celikonline/ormanyangindedektor/hardware/mechanical/ON1_mechanical.pdf

1

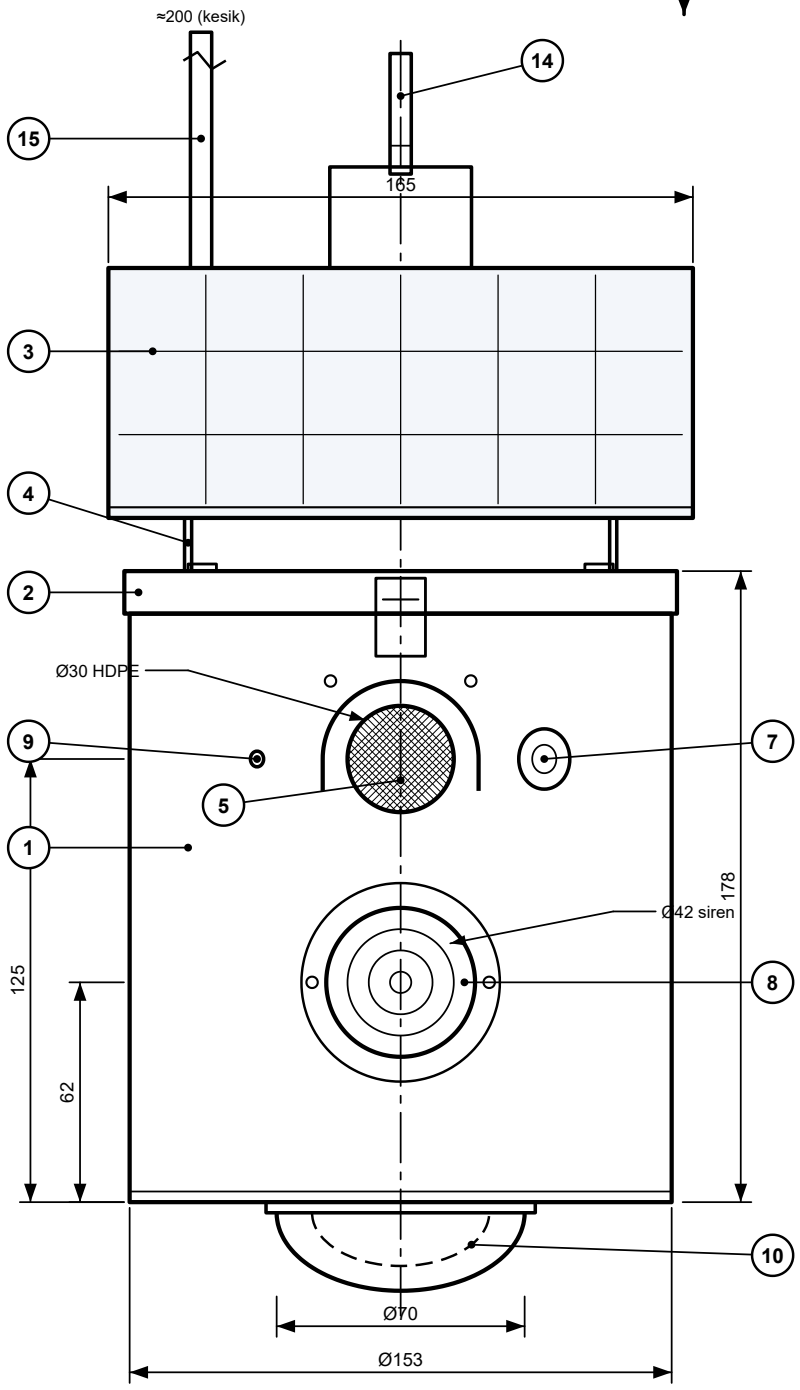
[picture p2: figure]
≈200 (kesik); Ø30 HDPE; Ø42 siren

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
A | A
B | B
C | C
D | D
E | E
F | F

## ORMAN NÖBETÇİSİ

Model ON-1

Proje / Çizim başlığı

## Orman Nöbetçisi ON-1 — Gövde montajı

Mekanik resim 1/2: ön, yan ve üst görünüşler

Doküman no
ON1-MEC-001

Revizyon
A

Tarih
2026-11-10

Sayfa
1/2

Boyut
A3 yatay

Ölçek
1:2

Çizen
Algosense Danışmanlık

Onay
—

Tek doğru kaynak: SPEC.md Rev A • Bu çizim programla üretilmiştir (hardware/tools) — elle düzenlemeyin.

# ÖN GÖRÜNÜŞ

## Ölçek 1:2

35°

FOV 60°

halat → dal

ağaç kabuğu

15

30°

### ≈ 195 (siperlik – braket)

### 117 (135 × cos30°)

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
10 11

# A — SAĞ YAN GÖRÜNÜŞ

## Ölçek 1:2 (ön solda, ağaç sağda)

görüş ±30°

ağaç (örnek Ø300; Ø150…600)

38° | 38°

32°

165

117

2

4

15 16

7

6

# B — ÜST GÖRÜNÜŞ

## Ölçek 1:2 (ön aşağıda)

A

B

## PARÇA / ÖZELLİK LİSTESİ

1

Gövde: kalaylı sac teneke Ø153 × 178, dış RAL 9010 ısı yansıtıcı epoksi, iç astar + 5 mm Al-yüzlü PE köpük

### 2 Kapak + EPDM conta + 3 paslanmaz kilit klipsi (0° / 120° / 240°)

### 3 Güneş paneli 6 V 3 W ETFE 165 × 135, 30° eğim — güneşlik görevi

4

Al 5052 panel braketi (2 yan yanak, 4×M4 kapağa), panel–kapak 15 mm hava boşluğu

### 5 Termal pencere Ø30: HDPE 0,4 mm + paslanmaz tel örgü (cam/akrilik yok)

### 6 Yağmur siperliği; AMG8833 ekseni yataydan 35° aşağı, FOV 60°

### 7 M12 ePTFE membran vent (BME680 haznesi), θ = +32°

### 8 Piezo siren Ø42, 12 V 105 dB, 2×M3 flanş

### 9 Durum LED’i ışık borusu Ø3, θ = −32°

### 10 Alt PC kubbe Ø70 (6 × 1 W LED halkası Ø50) + mıknatıs test noktası (SW3)

### 11 M8 ePTFE basınç dengeleme + labirentli drenaj (alt kapak)

### 12 Paslanmaz L braket 2 mm, 2×M5 + 10 mm aralayıcı, iç takviye pulu

### 13 Paslanmaz bant kelepçe (Ø15–60 cm ağaç), braket yarıklarından geçer

### 14 M6 mapa + 2 mm paslanmaz emniyet halatı (üst dala)

### 15 SMA dişi bulkhead (θ = 218°) + 90° adaptör + 3 dBi IP67 LTE anten (yukarı)

### 16 PG7 kablo rakoru (θ = 142°) — panel kablosu

## NOTLAR

1. Ölçüler mm. Genel tolerans ISO 2768-m. Delikler boyamadan önce açılır, çapakları alınır.
2. Tüm dış delikler EPDM/O-ring ile sızdırmaz; hedef IP54. Teneke iç yüzeyi astarlanır.
3. Anten zorunludur (teneke gövde Faraday kafesidir). Anten dikey yukarı.
4. Panel tabanı ile kapak arası ≥ 15 mm hava boşluğu: gövdeyi güneşten korur.
5. Delik konumları için sayfa 2 (delme şablonu) ve 1:1 şablon dosyalarına bakın.
6. Montaj yüksekliği 3–5 m; sensör yamaca / izlenecek alana bakacak şekilde döndürülür.

Görünüşler ok yöntemiyle (ISO 128-30) gösterilmiştir.

1

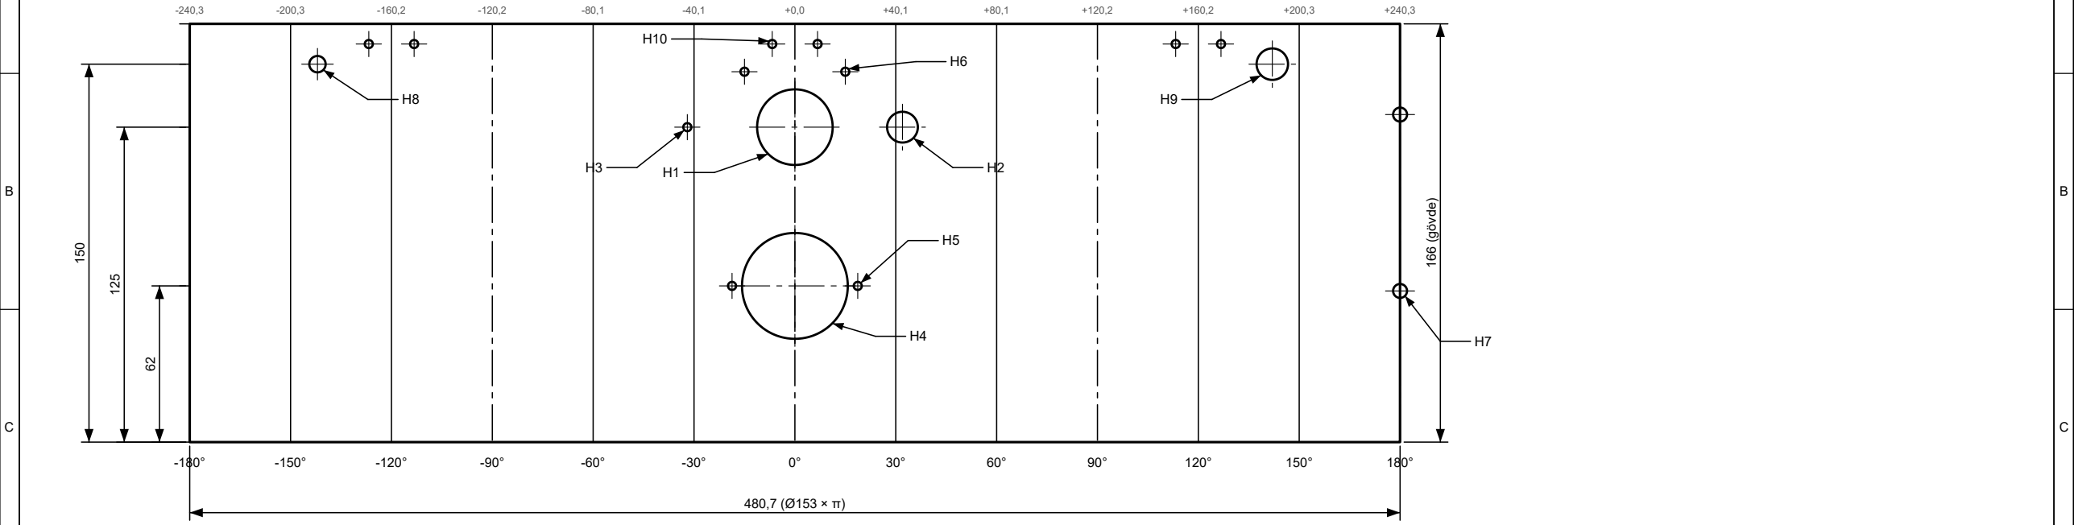
[picture p3: figure]
166 (gövde)

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
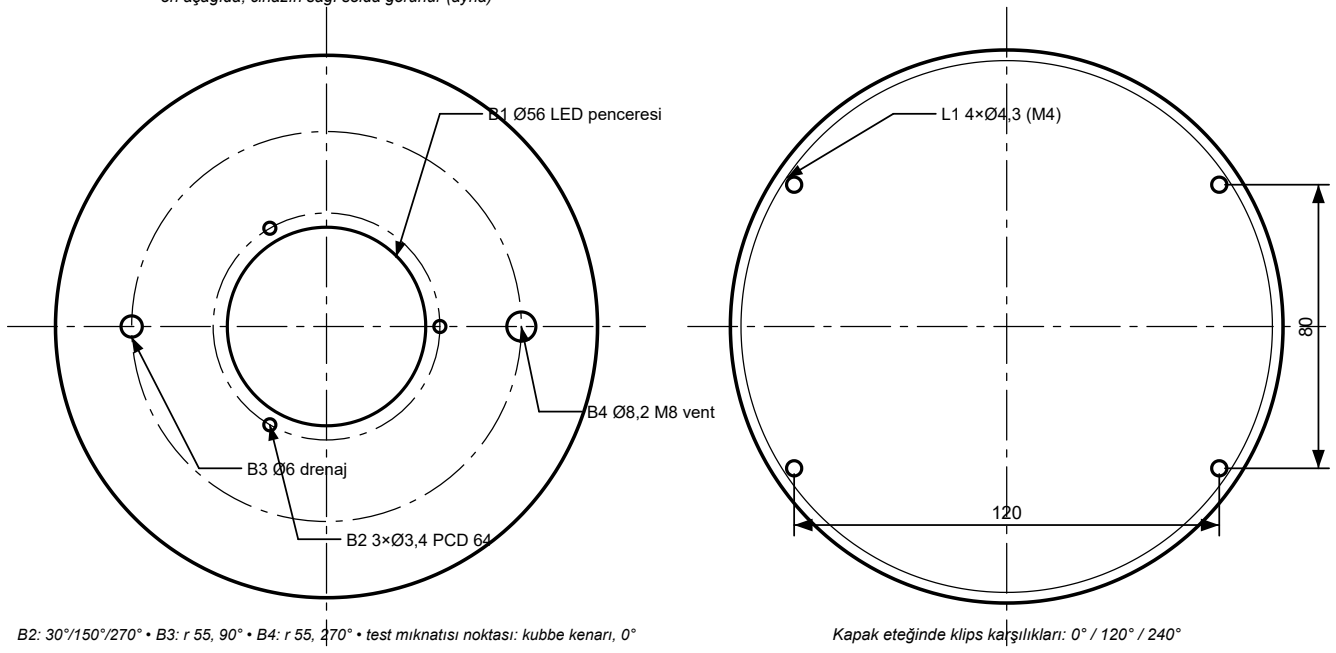
[picture p4: figure]
B1 Ø56 LED penceresi; B2 3×Ø3,4 PCD 64; B3 Ø6 drenaj; B4 Ø8,2 M8 vent

5

6

6

7

7

8

8

A | A
D | D
E | E
F | F

## ORMAN NÖBETÇİSİ

Model ON-1

Proje / Çizim başlığı

## Orman Nöbetçisi ON-1 — Delme şablonu

Mekanik resim 2/2: gövde, alt kapak, üst kapak

Doküman no
ON1-MEC-002

Revizyon
A

Tarih
2026-11-10

Sayfa
2/2

Boyut
A3 yatay

Ölçek
1:2

Çizen
Algosense Danışmanlık

Onay
—

Tek doğru kaynak: SPEC.md Rev A • Bu çizim programla üretilmiştir (hardware/tools) — elle düzenlemeyin.

ARKA | SOL | ÖN | SAĞ | ARKA

# GÖVDE YAN YÜZEY AÇINIMI (delme şablonu)

Ölçek 1:2 • yatay = yay uzunluğu s = R·θ (R = 76,5, çevre 480,7 mm) • dikey = tabandan yükseklik z

s (mm) →

## DELİK TABLOSU — yan yüzey (θ: önden saat yönünde, üstten bakış)

No | Özellik | θ (°) | s (mm) | z (mm) | Ø (mm) | Not
H1 | Termal pencere | 0 | +0,0 | 125 | 30 | HDPE 0,4 mm + tel örgü
H2 | M12 ePTFE vent | 32 | +42,7 | 125 | 12,2 | BME680 haznesi
H3 | Işık borusu | −32 | −42,7 | 125 | 3,2 | durum LED’i
H4 | Siren | 0 | +0,0 | 62 | 42 | flanş contalı
H5 | Siren flanş M3 | −18,7 / 18,7 | −25,0 / +25,0 | 62 | 3,2 | 2 adet, ±25 mm yay
H6 | Siperlik M3 | −15 / 15 | −20,0 / +20,0 | 147 | 3,2 | 2 adet, ±20 mm yay
H7 | L braket M5 | 180 | +240,3 | 60 / 130 | 5,5 | 2 adet, iç takviye pulu
H8 | SMA bulkhead | −142 | −189,6 | 150 | 6,5 | D-düz 6,0 mm, O-ring
H9 | PG7 rakor | 142 | +189,6 | 150 | 12,5 | panel kablosu
H10 | Klips perçini | 0 / 120 / −120, her biri ±6,74 | ±9,0 yay (merkez: 0 / ±160,2) | 158 | 3,2 | 6 adet (3 klips × 2)

## ALT KAPAK (taban) — dıştan (alttan) bakış

ön aşağıda; cihazın sağı solda görünür (ayna)

B2: 30°/150°/270° • B3: r 55, 90° • B4: r 55, 270° • test mıknatısı noktası: kubbe kenarı, 0°

## ÜST KAPAK — üstten bakış, ön aşağıda

Kapak eteğinde klips karşılıkları: 0° / 120° / 240°

1:1 şablonlar: ON1_drilling_template_wall_1to1.svg (520 × 230 mm) ve ON1_drilling_template_discs_1to1.svg (A3) — %100 ölçekle yazdırın, 100 mm kontrol çubuğunu ölçün.
