celikonline/ormanyangindedektor/hardware/mechanical/ON1_drilling_template.png

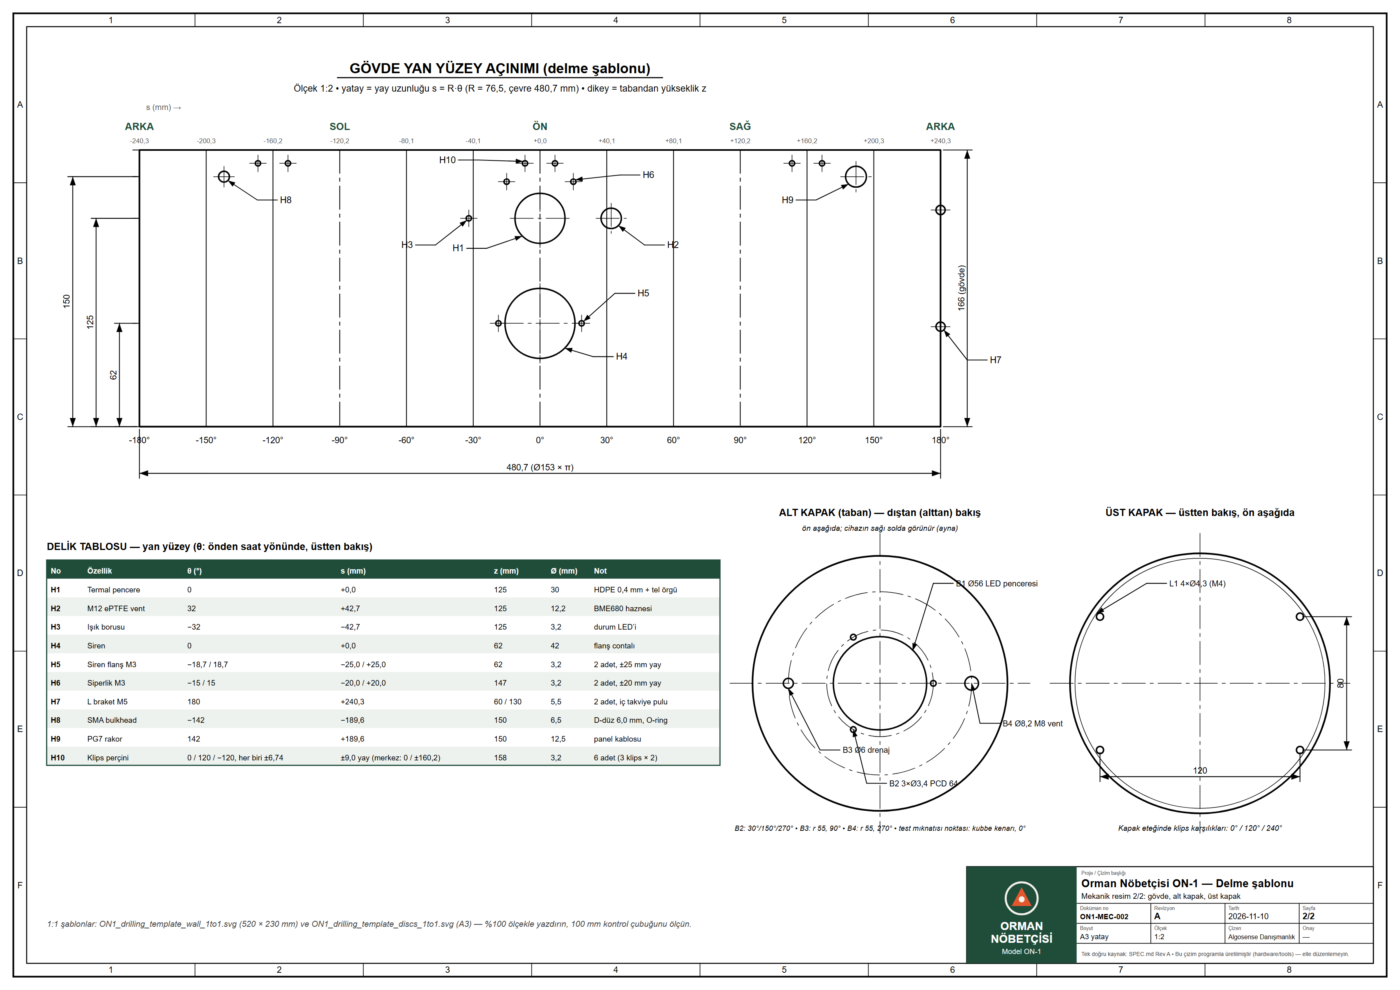
hardware/mechanical/ON1_drilling_template.png
