celikonline/ormanyangindedektor/hardware/pcb_diy/png/ON1-DIY_bakir_600dpi.png

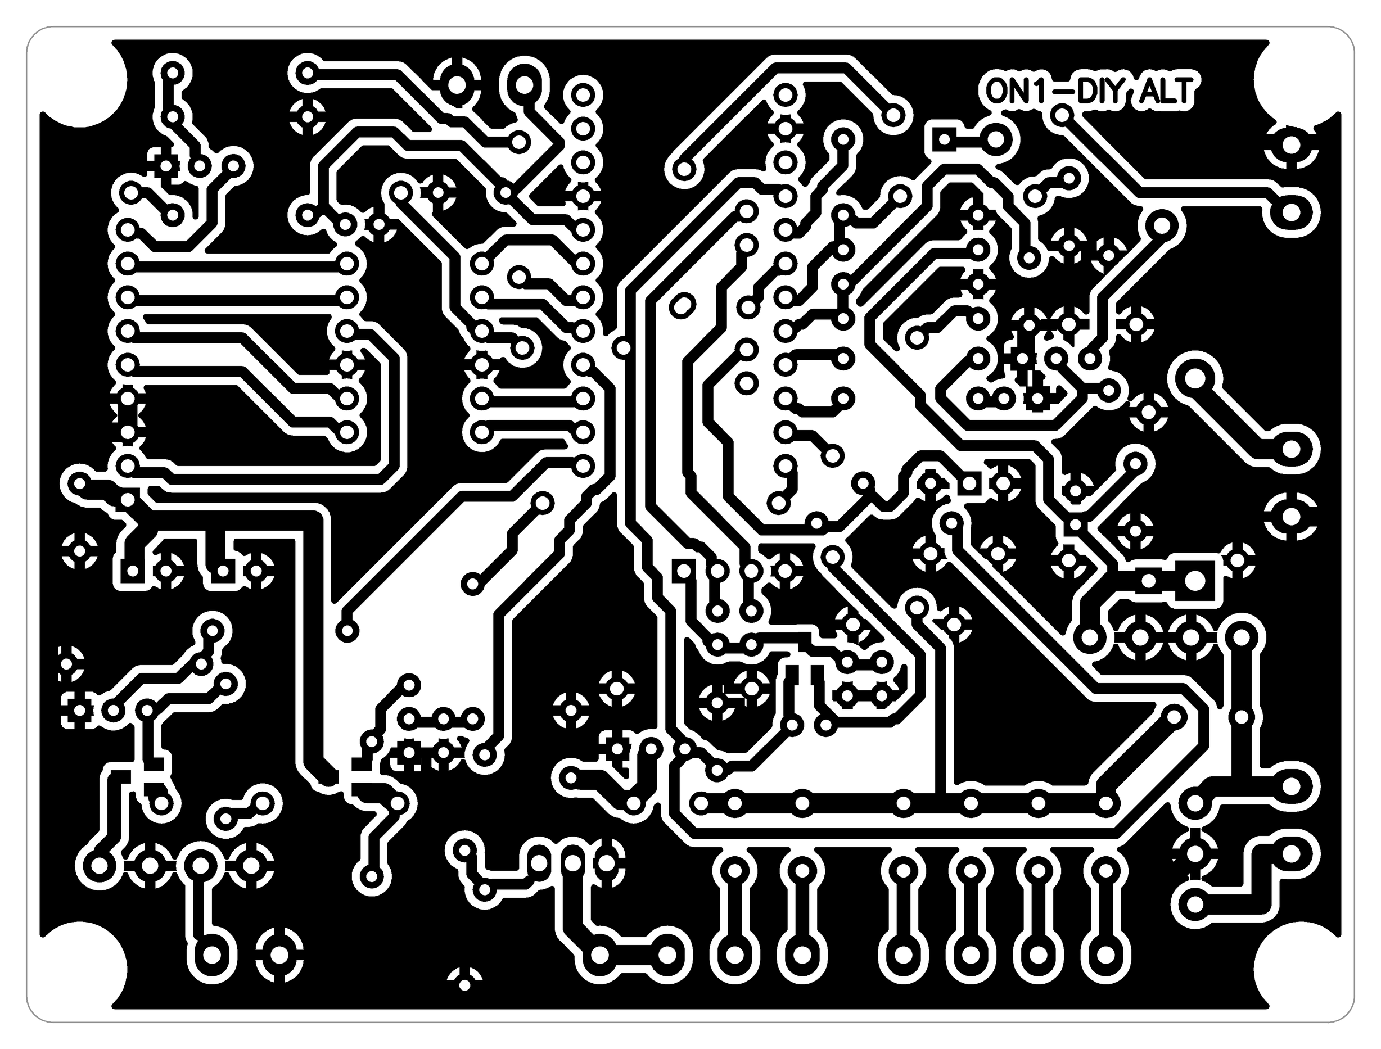
hardware/pcb_diy/png/ON1-DIY_bakir_600dpi.png
