celikonline/ormanyangindedektor/hardware/pcb_diy/png/ON1-DIY_onizleme_kompozit_600dpi.png

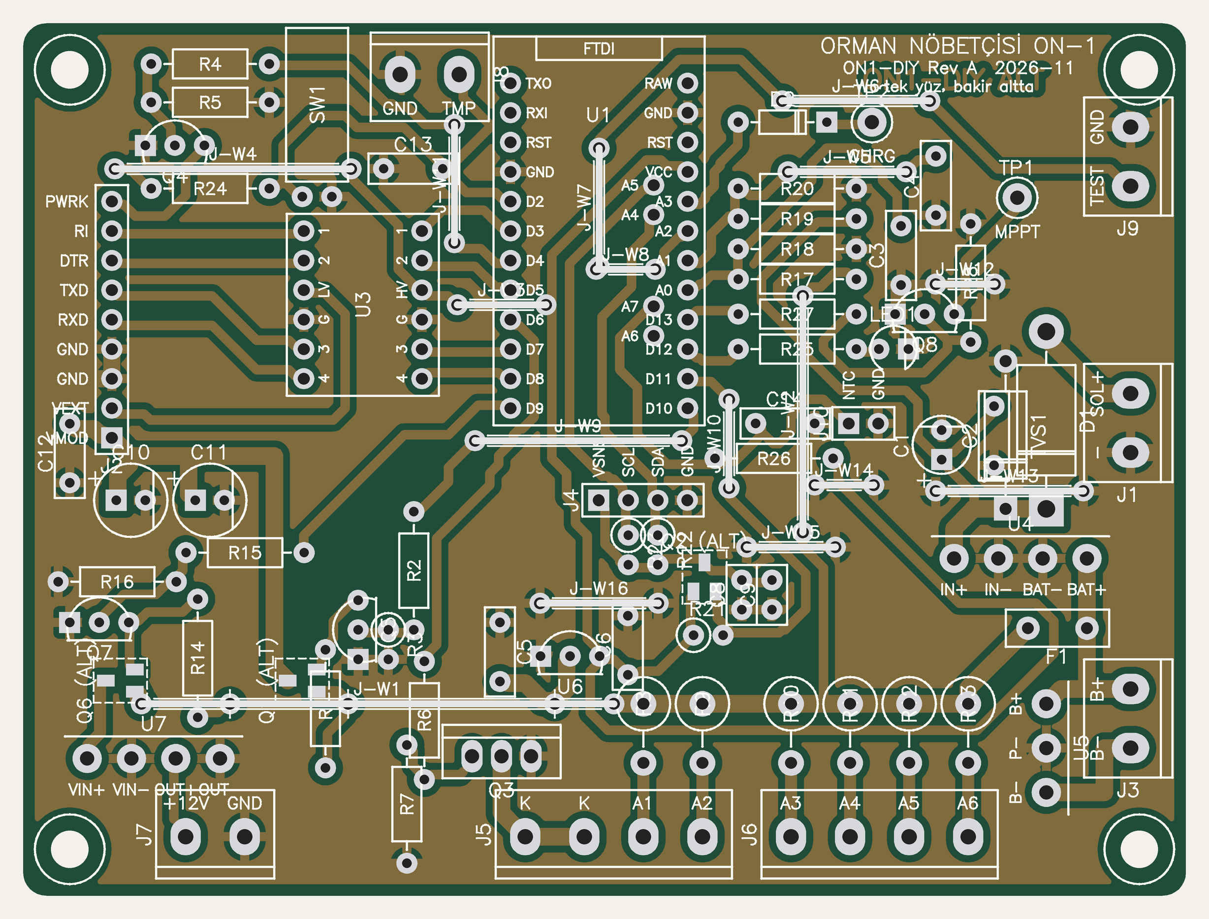
hardware/pcb_diy/png/ON1-DIY_onizleme_kompozit_600dpi.png
