celikonline/ormanyangindedektor/hardware/pcb_diy/png/ON1-DIY_onizleme_ust_600dpi.png

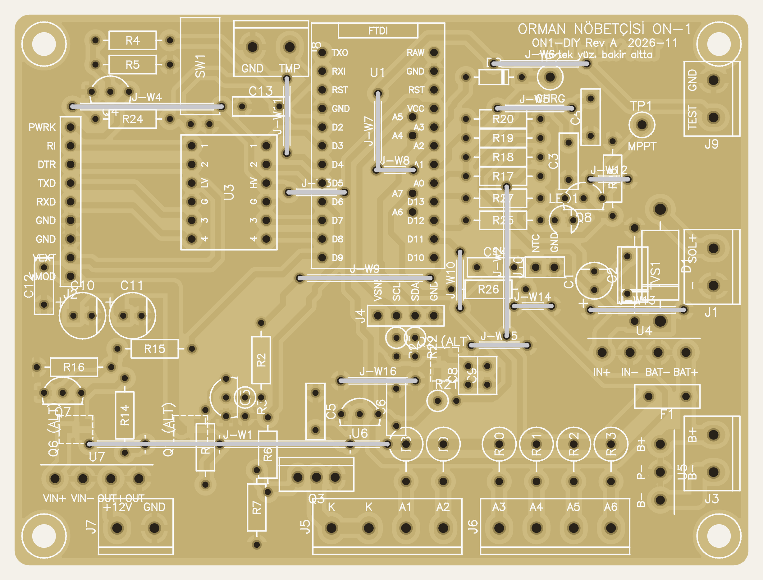
hardware/pcb_diy/png/ON1-DIY_onizleme_ust_600dpi.png
