celikonline/ormanyangindedektor/hardware/pcb_diy/png/ON1-DIY_serigrafi_600dpi.png

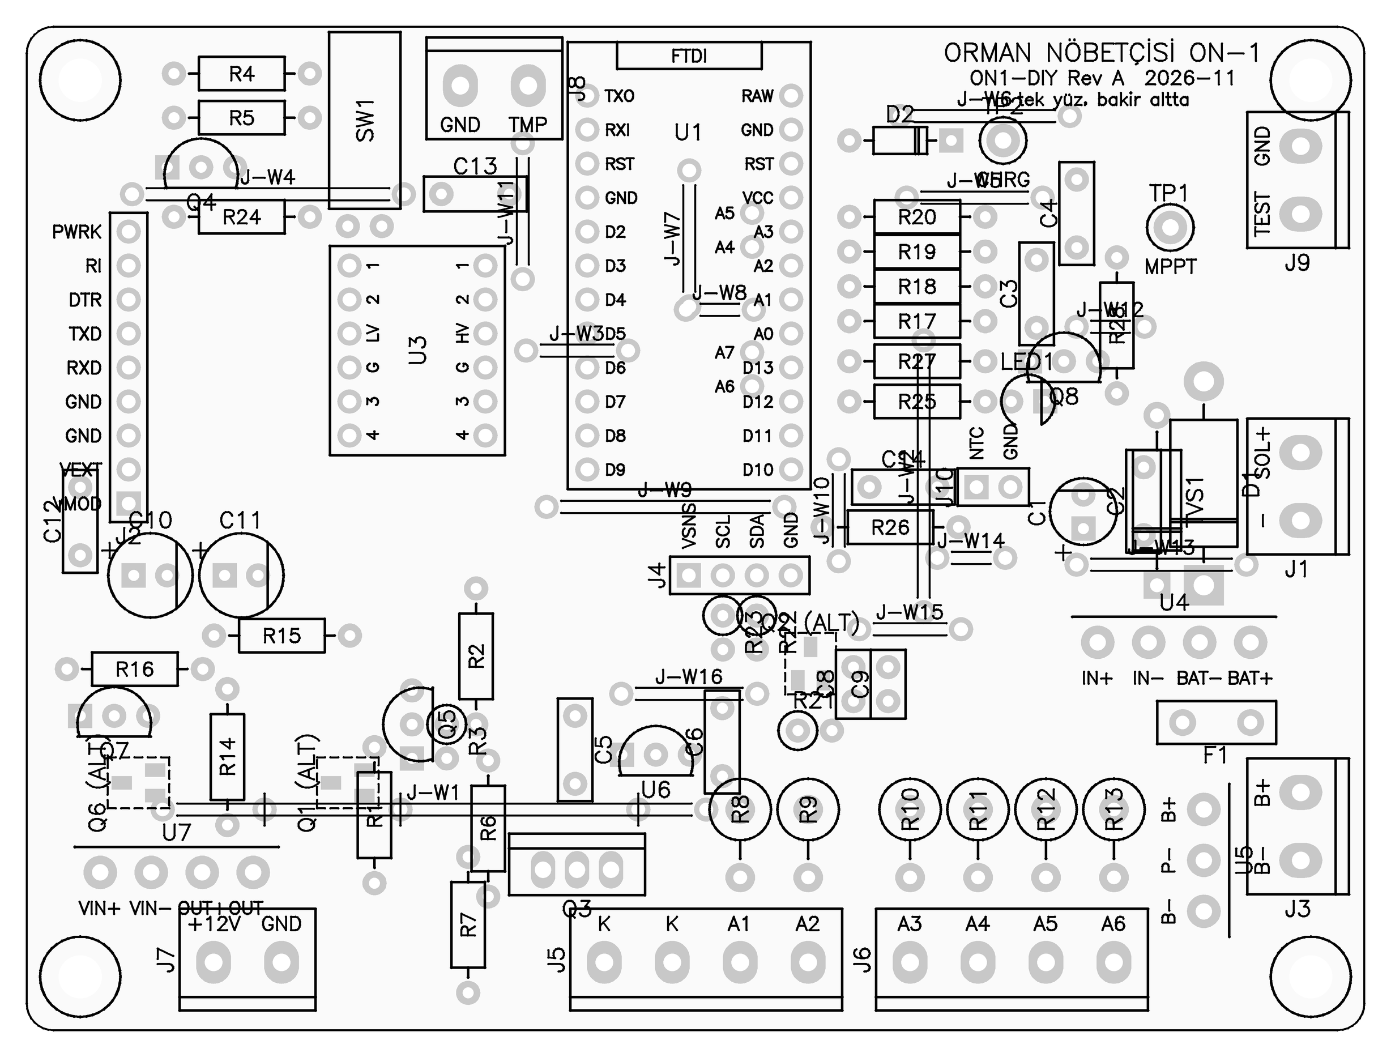
hardware/pcb_diy/png/ON1-DIY_serigrafi_600dpi.png
