celikonline/ormanyangindedektor/hardware/schematic/ON1-MB_RevA_schematic_sheet1.png

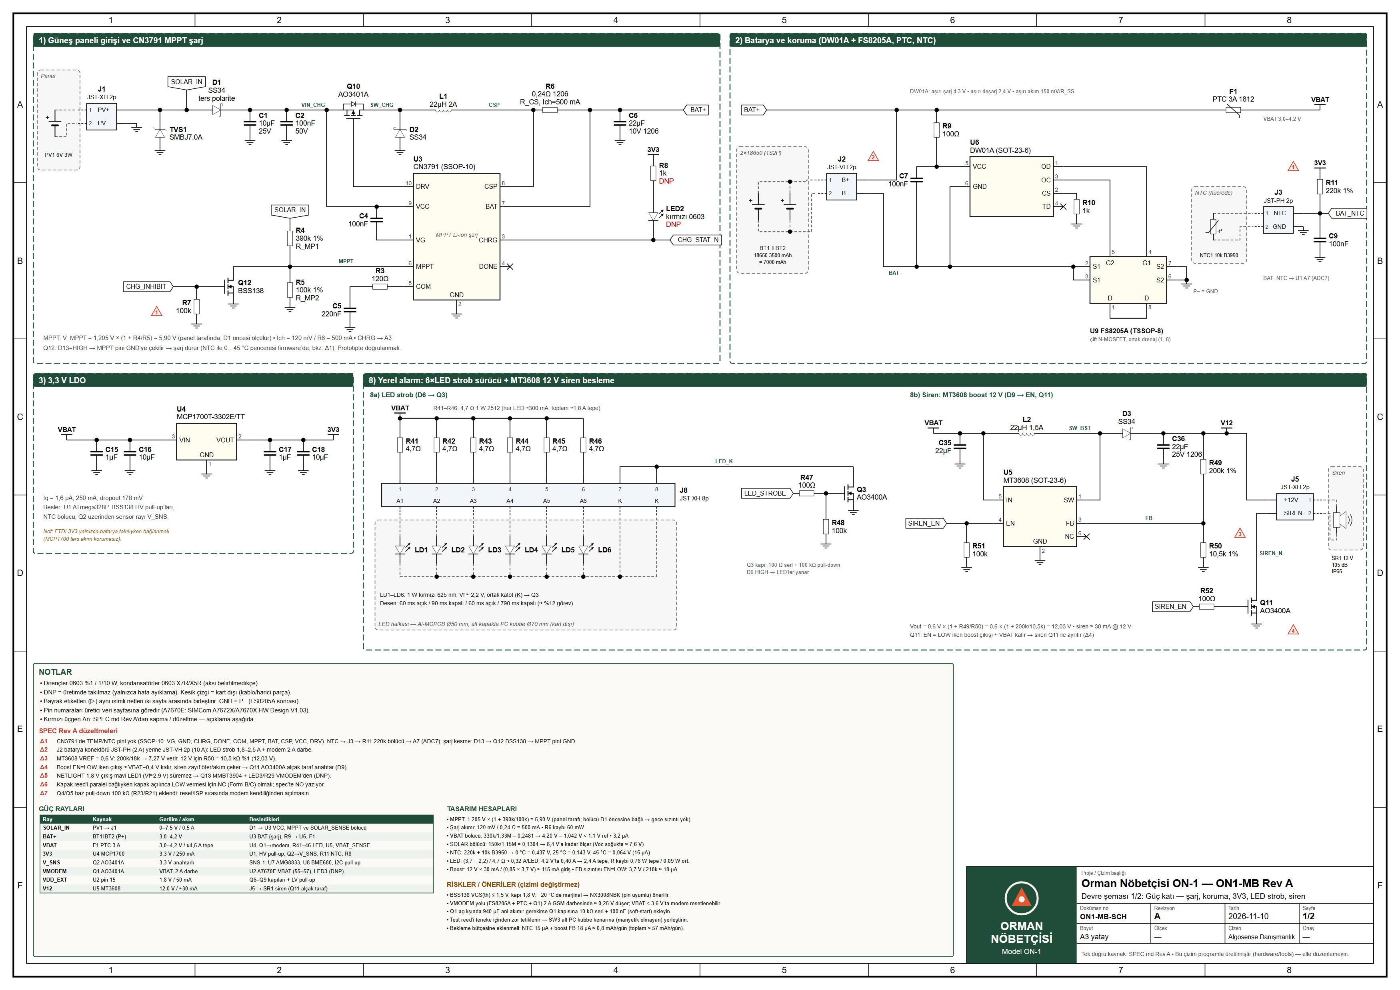
hardware/schematic/ON1-MB_RevA_schematic_sheet1.png
