celikonline/ormanyangindedektor/renders/on1_alarm.png

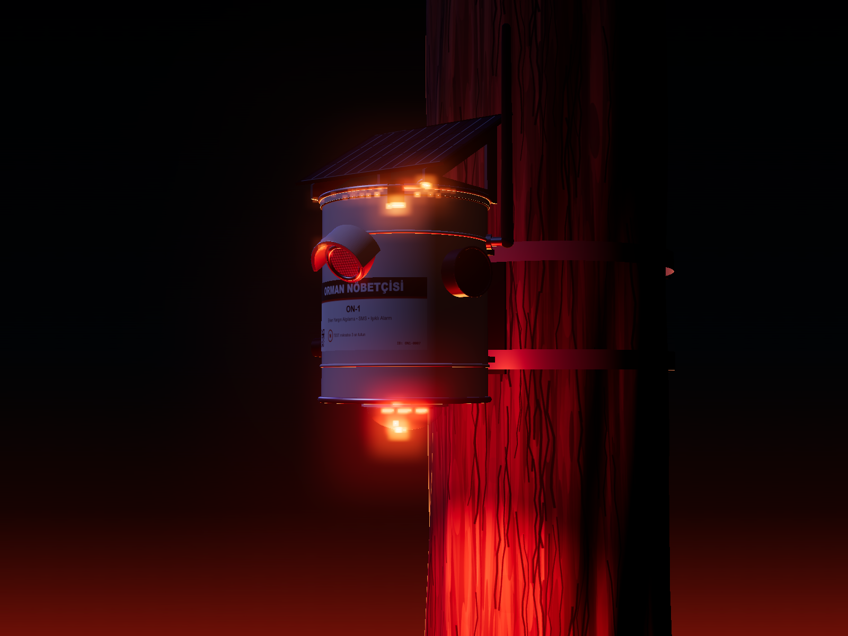
renders/on1_alarm.png
