celikonline/ormanyangindedektor/renders/on1_front.png

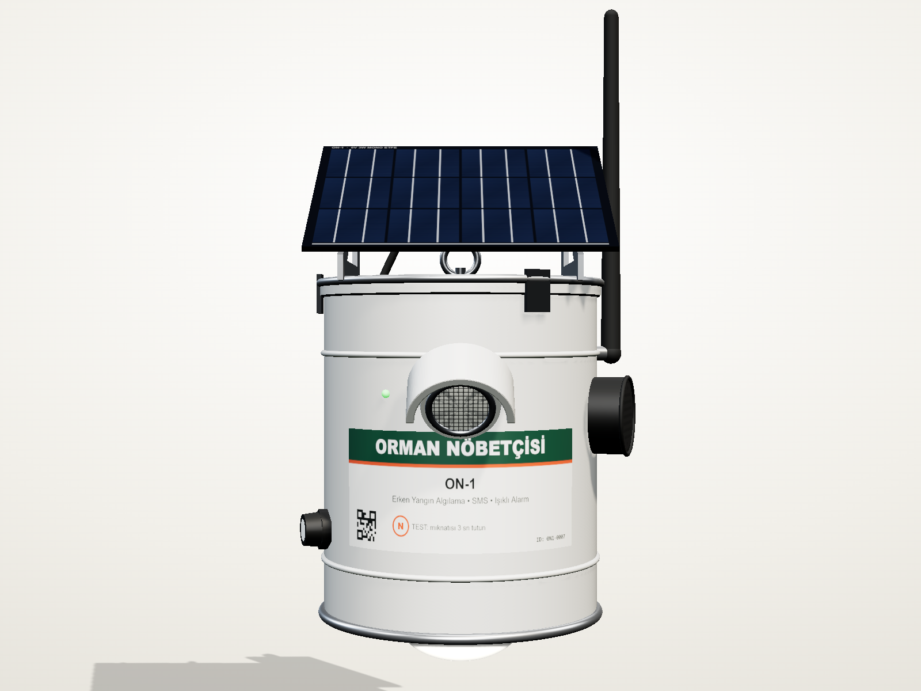
renders/on1_front.png
