celikonline/ormanyangindedektor/renders/on1_side.png

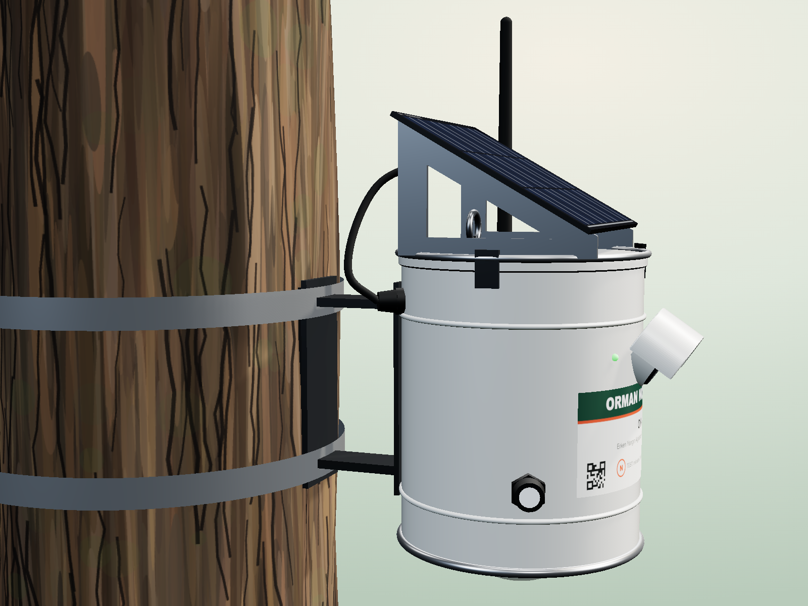
renders/on1_side.png
