celikonline/ormanyangindedektor/renders/on1_top.png

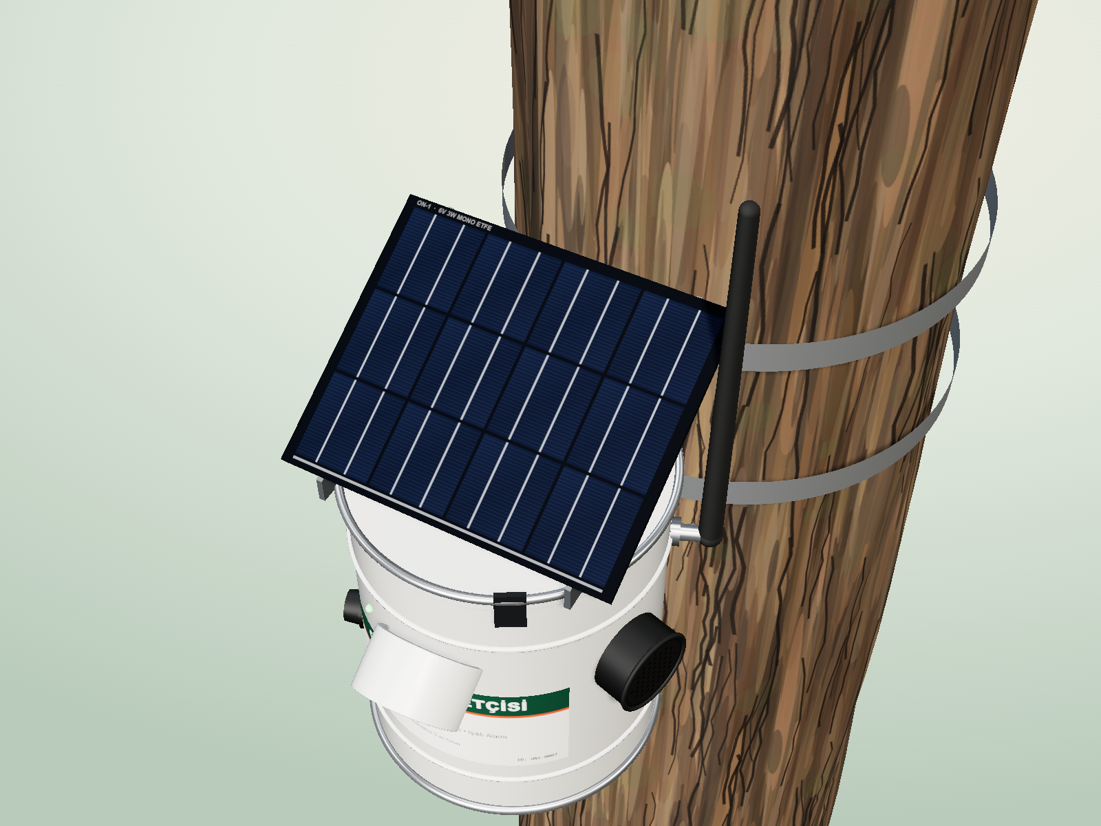
renders/on1_top.png
