celikonline/ormanyangindedektor/hardware/pcb_diy/print/ON1-DIY_bakir_fotorezist_film.pdf

Orman Nöbetçisi ON-1 • ON1-DIY ev yapımı taşıyıcı kart | Rev A — 2026-11-10

# Alt bakır (B.Cu) — POZİTİF FOTOREZİST için asetat film

Siyah = opak = bakır kalacak (pozitif rezist: ışık gören yer gelişir/çözülür). Asetat/transparan film, lazer yazıcı.

YAZDIRMA: %100 / "Gerçek boyut" seçin. "Sayfaya sığdır", "Fit to page", "Küçült" KAPALI olmalı. Yazdırdıktan sonra 50 mm ölçek çubuğunu cetvelle ölçün; 50,0 mm değilse tekrar yazdırın.
Toner yüzü bakıra (rezist yüzüne) değecek şekilde yerleştirin → ışık saçılması/alttan sızma en az olur.
Bu nedenle çıktı AYNALANMAMIŞTIR: film toner yüzü aşağı konduğunda bakırda doğru (alttan bakış) desen oluşur. Yoğunluk için iki filmi üst üste hizalayıp bantlayın (toner yoğunluğu ikiye katlanır). Kontrol yazısı: "ON1-DIY ALT".

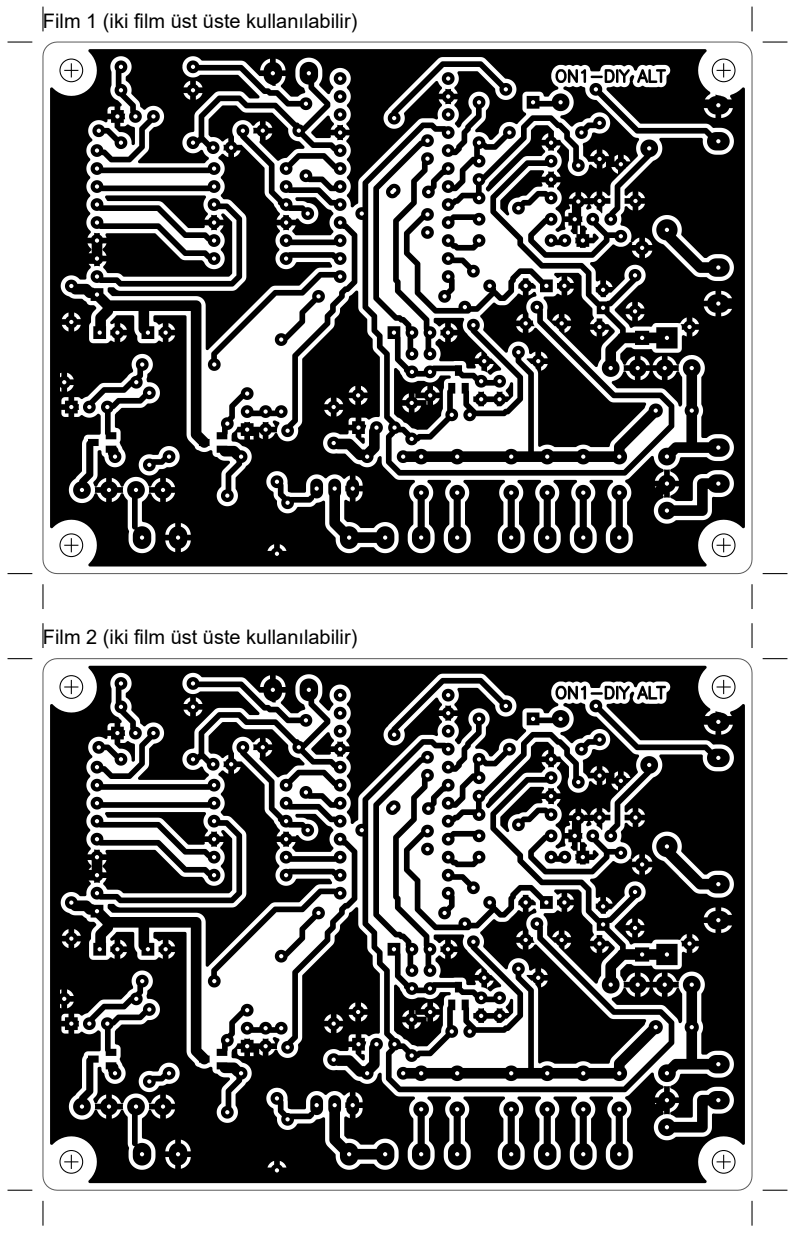
[picture p51: figure]

Film 1 (iki film üst üste kullanılabilir)

Film 2 (iki film üst üste kullanılabilir)

0 | 10 | 20 | 30 | 40 | 50
mm (cetvelle ölçün: tam 50,0 mm olmalı)

Pozlama: UV LED (395-405 nm) ~10 cm'den 60-120 s (önce test şeridi). Banyo: %0,5-1 NaOH (veya rezist üreticisinin banyosu).
