celikonline/ormanyangindedektor/hardware/pcb_diy/print/ON1-DIY_bakir_negatif.pdf

Orman Nöbetçisi ON-1 • ON1-DIY ev yapımı taşıyıcı kart | Rev A — 2026-11-10

# Alt bakır (B.Cu) — NEGATİF film (negatif kuru film / dry-film)

Şeffaf (beyaz) = bakır kalacak, siyah = aşınacak. Mavi/yeşil kuru film fotorezistler genelde NEGATİF çalışır.

YAZDIRMA: %100 / "Gerçek boyut" seçin. "Sayfaya sığdır", "Fit to page", "Küçült" KAPALI olmalı. Yazdırdıktan sonra 50 mm ölçek çubuğunu cetvelle ölçün; 50,0 mm değilse tekrar yazdırın.
Toner yüzü bakıra değecek şekilde yerleştirin; çıktı bu yüzden AYNALANMAMIŞTIR (alt katman, üstten bakış çizimi).
Kuru filmi 100-110 °C laminatörle bakıra yapıştırın, filmle UV pozlayın, koruyucu folyoyu soyup %1 Na2CO3 ile banyo yapın. Kontrol yazısı "ON1-DIY ALT" kâğıtta düz okunmalı. Siyah noktalar matkap merkezidir (aşınınca pedde küçük delik kalır).

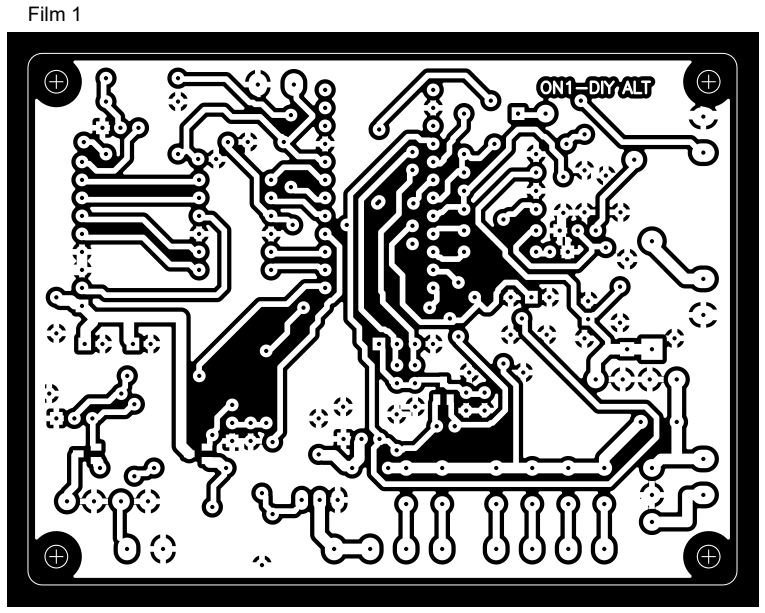
[picture p52: figure]
Film 1
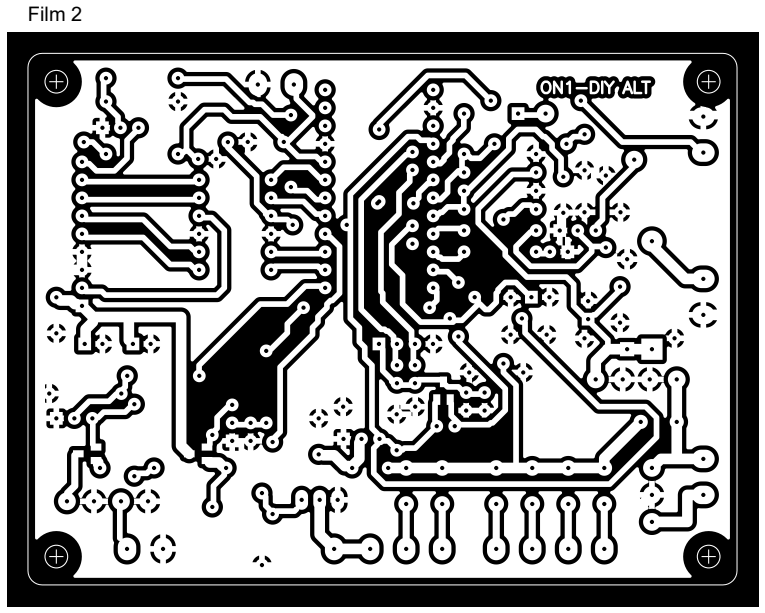
[picture p53: figure]
Film 2

0 | 10 | 20 | 30 | 40 | 50
mm (cetvelle ölçün: tam 50,0 mm olmalı)
