celikonline/ormanyangindedektor/hardware/pcb_diy/print/ON1-DIY_bakir_toner_transfer.pdf

Orman Nöbetçisi ON-1 • ON1-DIY ev yapımı taşıyıcı kart | Rev A — 2026-11-10

# Alt bakır (B.Cu) — TONER TRANSFER çıktısı (2 kopya)

Siyah = bakır kalacak. Lazer yazıcı + kuşe/parlak dergi kâğıdı veya toner-transfer kâğıdı.

YAZDIRMA: %100 / "Gerçek boyut" seçin. "Sayfaya sığdır", "Fit to page", "Küçült" KAPALI olmalı. Yazdırdıktan sonra 50 mm ölçek çubuğunu cetvelle ölçün; 50,0 mm değilse tekrar yazdırın.
Bu çıktı AYNALANMAMIŞTIR (bilerek). Bakır alt yüzdedir ve çizim üstten bakışla yapılmıştır; kâğıt
yüzü bakıra gelecek şekilde ters çevrilince görüntü kendiliğinden aynalanır ve bakırda doğru desen oluşur.
Kontrol: kâğıtta "ON1-DIY ALT" yazısı düz okunur; bakırda (alttan bakınca) ters okunur. Beyaz noktalar matkap merkezidir.

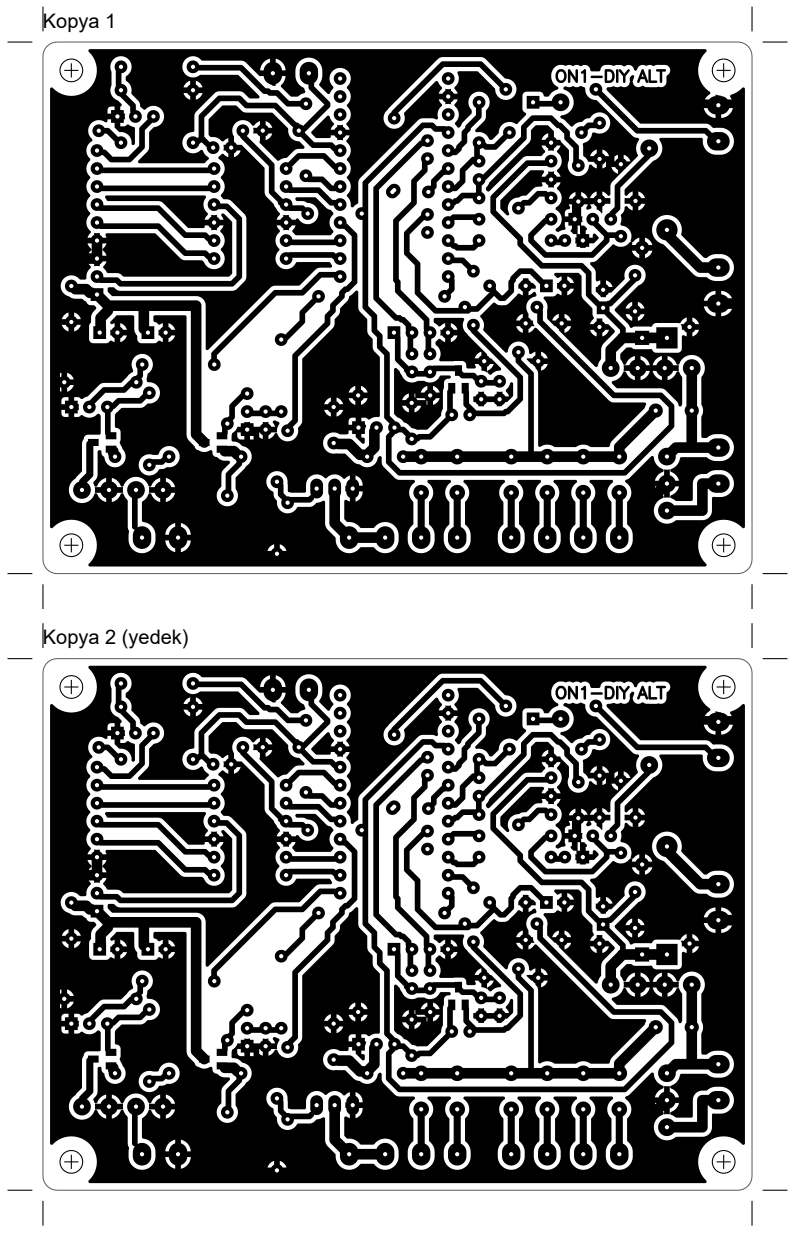
[picture p54: figure]
Kopya 1; Kopya 2 (yedek)

0 | 10 | 20 | 30 | 40 | 50
mm (cetvelle ölçün: tam 50,0 mm olmalı)

Kart: 100 × 75 mm, 1 katman, FR4 35 µm. Ütü: en yüksek (pamuk) ısı, 3-5 dk bastırarak; laminatör: 4-6 geçiş.
