celikonline/ormanyangindedektor/hardware/pcb_diy/print/ON1-DIY_delik_haritasi.pdf

Orman Nöbetçisi ON-1 • ON1-DIY ev yapımı taşıyıcı kart | Rev A — 2026-11-10

# Delik haritası (matkap planı) — 1:1

Üstten bakış. Her delik çapı gerçek boyutta çizildi; harf = matkap ucu (tabloya bakın).

YAZDIRMA: %100 / "Gerçek boyut" seçin. "Sayfaya sığdır", "Fit to page", "Küçült" KAPALI olmalı. Yazdırdıktan sonra 50 mm ölçek çubuğunu cetvelle ölçün; 50,0 mm değilse tekrar yazdırın. Delmeyi aşındırma ve kalaylamadan SONRA, bakır tarafından yapın (pedlerdeki merkez noktası ucu ortalar).
Önce en küçük uçla tüm delikleri açın, sonra büyük delikleri büyütün. Dik matkap standı + karbür uç önerilir.

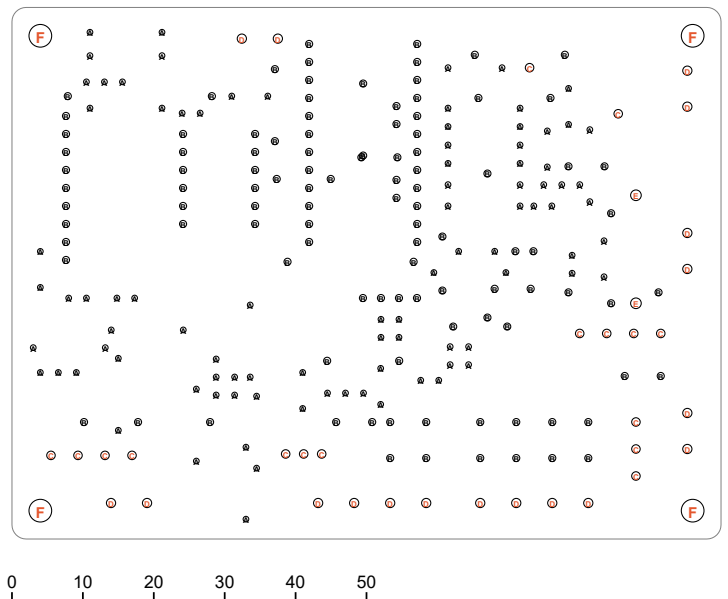
[picture p55: figure]

mm (cetvelle ölçün: tam 50,0 mm olmalı)

## Matkap tablosu

Harf | Çap (mm) | Adet | Matkap ucu | Kullanıldığı yer
A | 0,8 | 91 | 0,8 mm | C, D, LED, Q, R, SW, U
B | 1,0 | 106 | 1,0 mm | F, J, J-W, R, TVS, U
C | 1,2 | 16 | 1,2 mm | Q, TP, U
D | 1,3 | 18 | 1,3 mm | J
E | 1,5 | 2 | 1,5 mm | D
F | 3,2 | 4 | 3,2 mm | M3 montaj

### TOPLAM: 237 delik

Notlar: 0,8 mm uçla tüm küçük delikleri açtıktan sonra büyükleri büyütün. M3 delikleri için 3 mm uç + hafif rayba da olur. J-W = üst yüz atlama teli delikleri (bara teli J-W1 Ø1,0 mm tel kullanıyorsa 1,0 mm'ye büyütülebilir).
1N5822 (D1) bacakları kalındır: 1,5 mm. Klemensler 1,3 mm, TO-220/kablo pedleri 1,2 mm.
