celikonline/ormanyangindedektor/hardware/pcb_diy/print/ON1-DIY_yerlesim_ust.pdf

Orman Nöbetçisi ON-1 • ON1-DIY ev yapımı taşıyıcı kart | Rev A — 2026-11-10

# Üst yüz yerleşim / serigrafi — 1:1

Parçalar ÜST yüze (bakırsız yüz) takılır, bacaklar alt yüzdeki bakıra lehimlenir. Değerler mavi.

YAZDIRMA: %100 / "Gerçek boyut" seçin. "Sayfaya sığdır", "Fit to page", "Küçült" KAPALI olmalı. Yazdırdıktan sonra 50 mm ölçek çubuğunu cetvelle ölçün; 50,0 mm değilse tekrar yazdırın.
Bu sayfa 1:1'dir: üst yüze (bakırsız) yapıştırıp delik şablonu / serigrafi yerine kullanabilirsiniz (aynalanmamış).
Kalın gri çift çizgi + J-Wn = üst yüzde düz tel köprü (atlama teli). (ALT) işaretli SOT-23'ler bakır tarafına lehimlenir. Kutup: elektrolitik '+' kare ped; diyot bandı = K (kare ped); LED düz kenar = K; TO-92 düz yüz çizgisi; header 1. pin kare.

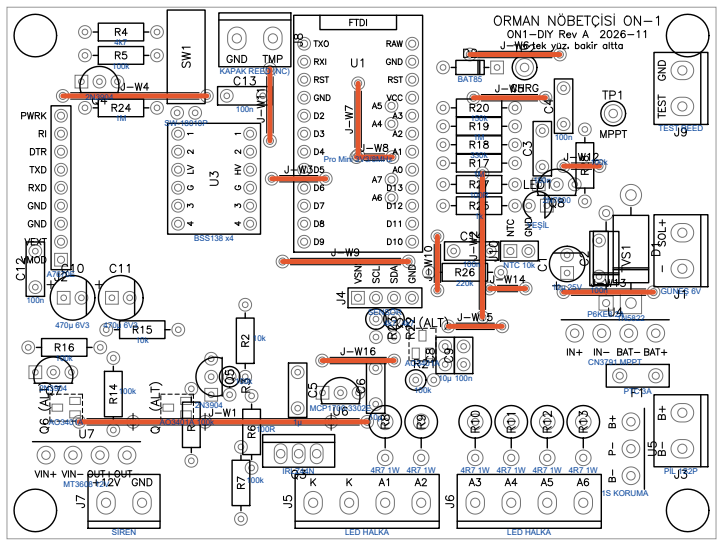
[picture p56: figure]
Pro Mini 3V3/8MHz; BSS138 x4; KAPAK REED (NC); SİREN; IRLZ44N; LED HALKA; MCP1700-3302E; NTC 10k; PİL 1S2P; 1S KORUMA; PTC 3A; GÜNEŞ 6V; CN3791 MPPT; BAT85; SENSÖR; TEST REED; YEŞİL

4R7 1W 4R7 1W | 4R7 1W 4R7 1W 4R7 1W 4R7 1W
0 | 10 | 20 | 30 | 40 | 50
mm (cetvelle ölçün: tam 50,0 mm olmalı)

Atlama telleri (üst yüz, Ø0,6-0,8 mm kalaylı bakır tel, önce bunları takın):
J-W1: VBAT, 40.64 mm J-W2: VBAT, 20.32 mm J-W3: +3V3, 7.62 mm
J-W4: +3V3, 20.32 mm J-W5: A1_SOLAR, 10.16 mm J-W6: A2_TEST, 12.70 mm
J-W7: A2_TEST, 10.16 mm J-W8: A2_TEST, 5.08 mm J-W9: D10_MODEM_EN, 17.78 mm J-W10: D11_SNS_N, 7.62 mm J-W11: D4_PWRKEY, 10.16 mm J-W12: GND, 5.08 mm J-W13: GND, 12.70 mm J-W14: GND, 5.08 mm J-W15: GND, 7.62 mm
J-W16: GND, 10.16 mm

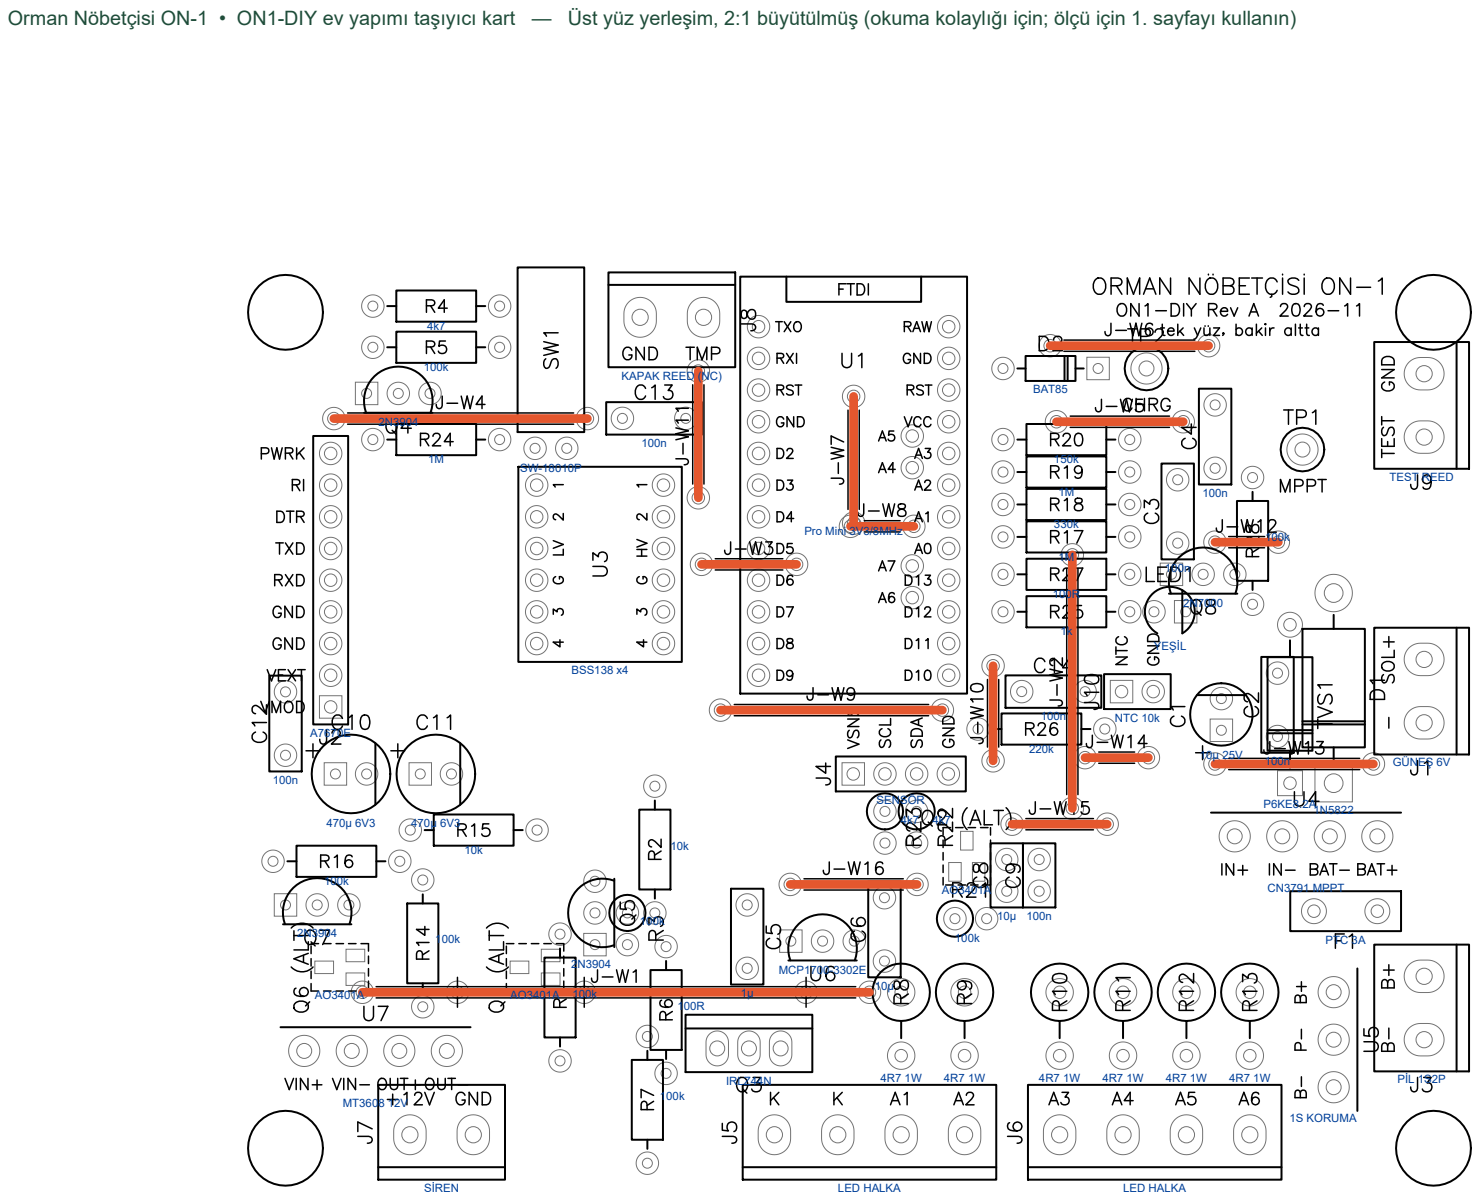
[picture p57: page 2]
Pro Mini 3V3/8MHz; BSS138 x4; SİREN; IRLZ44N; LED HALKA; MCP1700-3302E; NTC 10k; PİL 1S2P; 1S KORUMA; PTC 3A; GÜNEŞ 6V; CN3791 MPPT; BAT85; SENSÖR; TEST REED; YEŞİL

Orman Nöbetçisi ON-1 • ON1-DIY ev yapımı taşıyıcı kart — Üst yüz yerleşim, 2:1 büyütülmüş (okuma kolaylığı için; ölçü için 1. sayfayı kullanın)

KAPAK REED (NC)

Orman Nöbetçisi ON-1 • ON1-DIY ev yapımı taşıyıcı kart — ALT yüz (bakır tarafı) görünümü, 2:1, aynalı: SOT-23 parçalar buraya lehimlenir

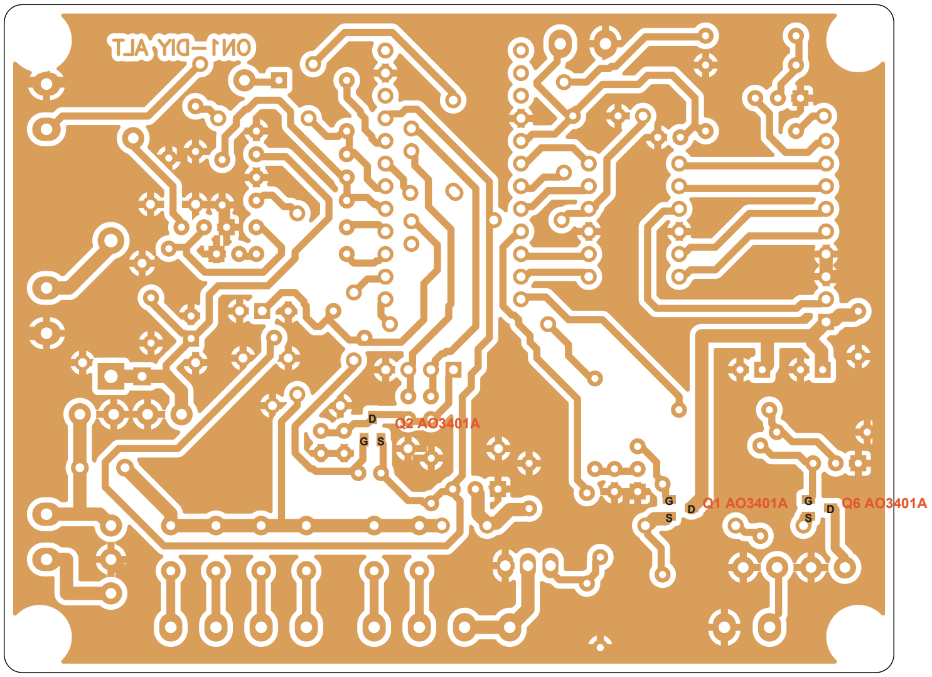
[picture p58: figure]

G = kapı (gate), S = kaynak (source), D = savak (drain). AO3401A gövdesindeki nokta/pin-1 = G. Önce bir pedi kalaylayın, parçayı cımbızla tutup o pedi eritin, sonra diğer bacakları lehimleyin.
