celikonline/ormanyangindedektor/hardware/schematic/ON1-MB_RevA_schematic.pdf

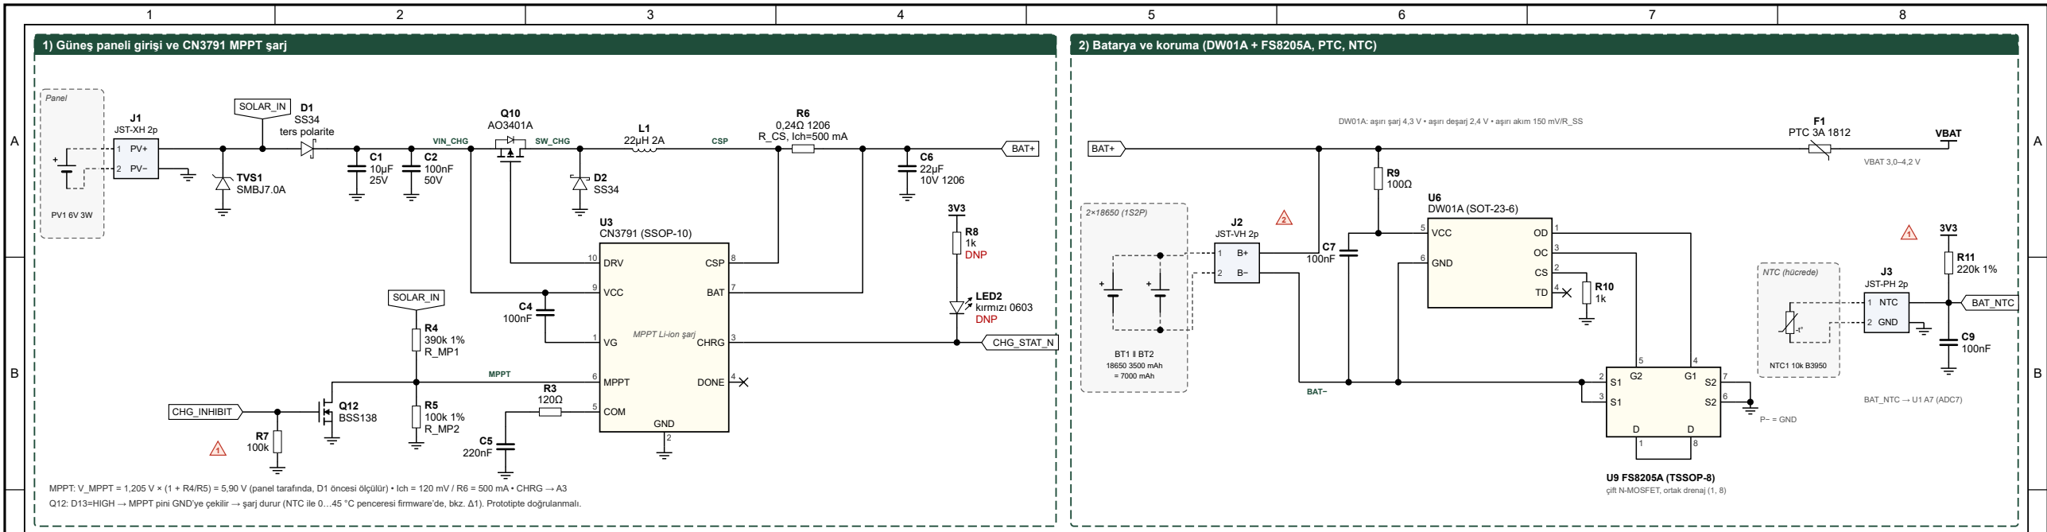
[picture p59: figure]
Panel; NTC (hücrede); J1 JST-XH 2p; TVS1 SMBJ7.0A; D1 SS34 ters polarite; R6 0,24Ω 1206 R_CS, Ich=500 mA; DRV; VCC; MPPT; COM; CSP; BAT; CHRG; DONE; GND 2; U3 CN3791 (SSOP-10); MPPT Li-ion şarj; Q12 BSS138; LED2 kırmızı 0603 DNP; R8 1k DNP; 18650 3500 mAh = 7000 mAh; J2 JST-VH 2p; GND; U6 DW01A (SOT-23-6); U9 FS8205A (TSSOP-8); çift N-MOSFET, ortak drenaj (1, 8); P− = GND; F1 PTC 3A 1812; VBAT 3,0–4,2 V; NTC1 10k B3950; 1 NTC; 2 GND; J3 JST-PH 2p; BAT_NTC → U1 A7 (ADC7); SOLAR_IN; VIN_CHG; SW_CHG; BAT+; CHG_INHIBIT; CHG_STAT_N; BAT−; VBAT; BAT_NTC
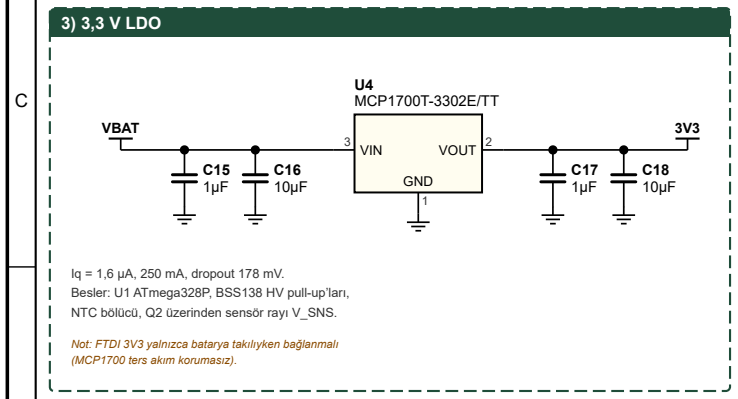
[picture p60: figure]
VIN; VOUT; GND 1; U4 MCP1700T-3302E/TT; Iq = 1,6 µA, 250 mA, dropout 178 mV.; (MCP1700 ters akım korumasız).; VBAT

1

2

3

4

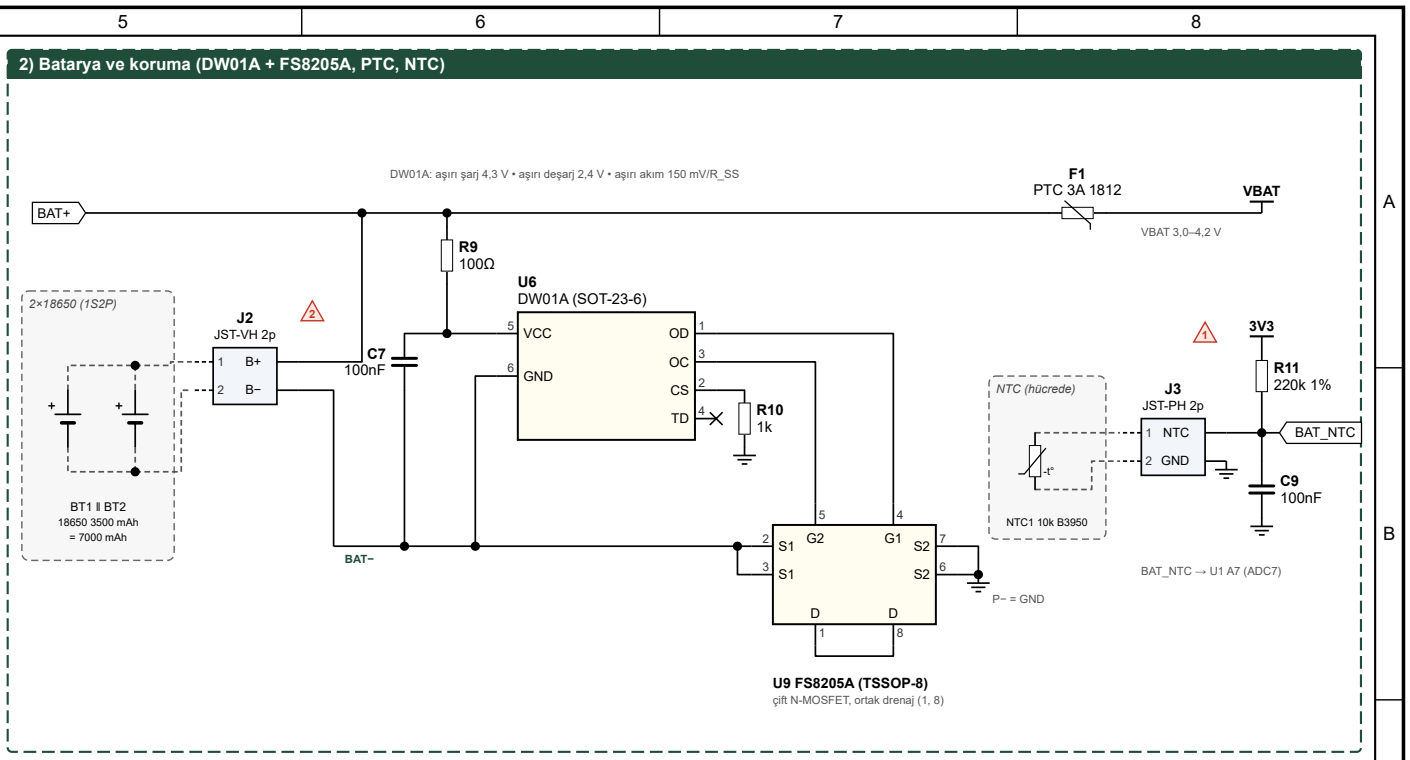
[picture p61: figure]

5

6

7

8

C | C
D | D
E | E
F | F

# ORMAN NÖBETÇİSİ

## Model ON-1

Proje / Çizim başlığı

# Orman Nöbetçisi ON-1 — ON1-MB Rev A

## Devre şeması 1/2: Güç katı — şarj, koruma, 3V3, LED strob, siren

Doküman no

## ON1-MB-SCH

Revizyon
A

Tarih
2026-11-10

Sayfa
1/2

Boyut

## A3 yatay

Ölçek
—

Çizen

## Algosense Danışmanlık

Onay
—

Tek doğru kaynak: SPEC.md Rev A • Bu çizim programla üretilmiştir (hardware/tools) — elle düzenlemeyin.

## 1) Güneş paneli girişi ve CN3791 MPPT şarj

## 2) Batarya ve koruma (DW01A + FS8205A, PTC, NTC)

3) 3,3 V LDO | 8) Yerel alarm: 6×LED strob sürücü + MT3608 12 V siren besleme

### LED halkası — Al-MCPCB Ø50 mm, alt kapakta PC kubbe Ø70 mm (kart dışı)

### Siren

MPPT: V_MPPT = 1,205 V × (1 + R4/R5) = 5,90 V (panel tarafında, D1 öncesi ölçülür) • Ich = 120 mV / R6 = 500 mA • CHRG → A3 Q12: D13=HIGH → MPPT pini GND’ye çekilir → şarj durur (NTC ile 0…45 °C penceresi firmware’de, bkz. Δ1). Prototipte doğrulanmalı.

DW01A: aşırı şarj 4,3 V • aşırı deşarj 2,4 V • aşırı akım 150 mV/R_SS

Besler: U1 ATmega328P, BSS138 HV pull-up’ları, NTC bölücü, Q2 üzerinden sensör rayı V_SNS.

Not: FTDI 3V3 yalnızca batarya takılıyken bağlanmalı

8a) LED strob (D6 → Q3) | 8b) Siren: MT3608 boost 12 V (D9 → EN, Q11)

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
### JST-XH 8p

R41
4,7Ω

R42
4,7Ω

R43
4,7Ω

R44
4,7Ω

R45
4,7Ω

R46
4,7Ω

### R41–R46: 4,7 Ω 1 W 2512 (her LED ≈300 mA, toplam ≈1,8 A tepe)

LD1 | LD2 | LD3 | LD4 | LD5 | LD6

### LD1–LD6: 1 W kırmızı 625 nm, Vf ≈ 2,2 V, ortak katot (K) → Q3 Desen: 60 ms açık / 90 ms kapalı / 60 ms açık / 790 ms kapalı (≈ %12 görev)

Q3

## AO3400A

R47
100Ω

R48
100k

Q3 kapı: 100 Ω seri + 100 kΩ pull-down D6 HIGH → LED’ler yanar

C35
22µF

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
## GND

2

U5

## MT3608 (SOT-23-6)

L2

## 22µH 1,5A

D3
SS34

C36
22µF
25V 1206
R49
200k 1%

R50
10,5k 1%

R51
100k

+12V 1

### SİREN− 2

J5

### JST-XH 2p

Q11

## AO3400A

R52
100Ω

SR1 12 V
105 dB
IP65

### Vout = 0,6 V × (1 + R49/R50) = 0,6 × (1 + 200k/10,5k) = 12,03 V • siren ≈ 30 mA @ 12 V Q11: EN = LOW iken boost çıkışı ≈ VBAT kalır → siren Q11 ile ayrılır (Δ4)

## NOTLAR

- Dirençler 0603 %1 / 1/10 W, kondansatörler 0603 X7R/X5R (aksi belirtilmedikçe).
- DNP = üretimde takılmaz (yalnızca hata ayıklama). Kesik çizgi = kart dışı (kablo/harici parça).
- Bayrak etiketleri (▷) aynı isimli netleri iki sayfa arasında birleştirir. GND = P− (FS8205A sonrası).
- Pin numaraları üretici veri sayfasına göredir (A7670E: SIMCom A7672X/A7670X HW Design V1.03).
- Kırmızı üçgen Δn: SPEC.md Rev A’dan sapma / düzeltme — açıklama aşağıda.

## SPEC Rev A düzeltmeleri

Δ1 | CN3791’de TEMP/NTC pini yok (SSOP-10: VG, GND, CHRG, DONE, COM, MPPT, BAT, CSP, VCC, DRV). NTC → J3 → R11 220k bölücü → A7 (ADC7); şarj kesme: D13 → Q12 BSS138 → MPPT pini GND.
Δ2 | J2 batarya konektörü JST-PH (2 A) yerine JST-VH 2p (10 A): LED strob 1,8–2,5 A + modem 2 A darbe.
Δ3 | MT3608 VREF = 0,6 V: 200k/18k → 7,27 V verir. 12 V için R50 = 10,5 kΩ %1 (12,03 V).
Δ4 | Boost EN=LOW iken çıkış ≈ VBAT−0,4 V kalır, siren zayıf öter/akım çeker → Q11 AO3400A alçak taraf anahtar (D9).
Δ5 | NETLIGHT 1,8 V çıkış mavi LED’i (Vf≈2,9 V) süremez → Q13 MMBT3904 + LED3/R29 VMODEM’den (DNP).
Δ6 | Kapak reed’i paralel bağlıyken kapak açılınca LOW vermesi için NC (Form-B/C) olmalı; spec’te NO yazıyor.
Δ7 | Q4/Q5 baz pull-down 100 kΩ (R23/R21) eklendi: reset/ISP sırasında modem kendiliğinden açılmasın.

## GÜÇ RAYLARI

Ray | Kaynak | Gerilim / akım | Besledikleri
SOLAR_IN | PV1 → J1 | 0–7,5 V / 0,5 A | D1 → U3 VCC, MPPT ve SOLAR_SENSE bölücü
BAT+ | BT1ǁBT2 (P+) | 3,0–4,2 V | U3 BAT (şarj), R9 → U6, F1
VBAT | F1 PTC 3 A | 3,0–4,2 V / ≤4,5 A tepe | U4, Q1→modem, R41–46 LED, U5, VBAT_SENSE
3V3 | U4 MCP1700 | 3,3 V / 250 mA | U1, HV pull-up, Q2→V_SNS, R11 NTC, R8
V_SNS | Q2 AO3401A | 3,3 V anahtarlı | SNS-1: U7 AMG8833, U8 BME680, I2C pull-up
VMODEM | Q1 AO3401A | VBAT, 2 A darbe | U2 A7670E VBAT (55–57), LED3 (DNP)
VDD_EXT | U2 pin 15 | 1,8 V / 50 mA | Q6–Q9 kapıları + LV pull-up
V12 | U5 MT3608 | 12,0 V / ≈30 mA | J5 → SR1 siren (Q11 alçak taraf)

## TASARIM HESAPLARI

- MPPT: 1,205 V × (1 + 390k/100k) = 5,90 V (panel tarafı; bölücü D1 öncesine bağlı → gece sızıntı yok)
- Şarj akımı: 120 mV / 0,24 Ω = 500 mA • R6 kaybı 60 mW
- VBAT bölücü: 330k/1,33M = 0,2481 → 4,20 V = 1,042 V < 1,1 V ref • 3,2 µA
- SOLAR bölücü: 150k/1,15M = 0,1304 → 8,4 V’a kadar ölçer (Voc soğukta ≈ 7,6 V)
- NTC: 220k + 10k B3950 → 0 °C = 0,437 V, 25 °C = 0,143 V, 45 °C = 0,064 V (15 µA)
- LED: (3,7 − 2,2) / 4,7 Ω ≈ 0,32 A/LED; 4,2 V’ta 0,40 A → 2,4 A tepe, R kaybı 0,76 W tepe / 0,09 W ort.
- Boost: 12 V × 30 mA / (0,85 × 3,7 V) ≈ 115 mA giriş • FB sızıntısı EN=LOW: 3,7 V / 210k ≈ 18 µA

## RİSKLER / ÖNERİLER (çizimi değiştirmez)

- BSS138 VGS(th) ≤ 1,5 V, kapı 1,8 V: −20 °C’de marjinal → NX3008NBK (pin uyumlu) önerilir.
- VMODEM yolu (FS8205A + PTC + Q1) 2 A GSM darbesinde ≈ 0,25 V düşer; VBAT < 3,6 V’ta modem resetlenebilir.
- Q1 açılışında 940 µF ani akımı: gerekirse Q1 kapısına 10 kΩ seri + 100 nF (soft-start) ekleyin.
- Test reed’i teneke içinden zor tetiklenir → SW3 alt PC kubbe kenarına (manyetik olmayan) yerleştirin.
- Bekleme bütçesine eklenmeli: NTC 15 µA + boost FB 18 µA ≈ 0,8 mAh/gün (toplam ≈ 57 mAh/gün).

## VBAT

LED_K

## LED_STROBE

## VBAT

3

V12

## SIREN_EN

## SIREN_EN

4

SIREN_N

SW_BST

FB

1

2

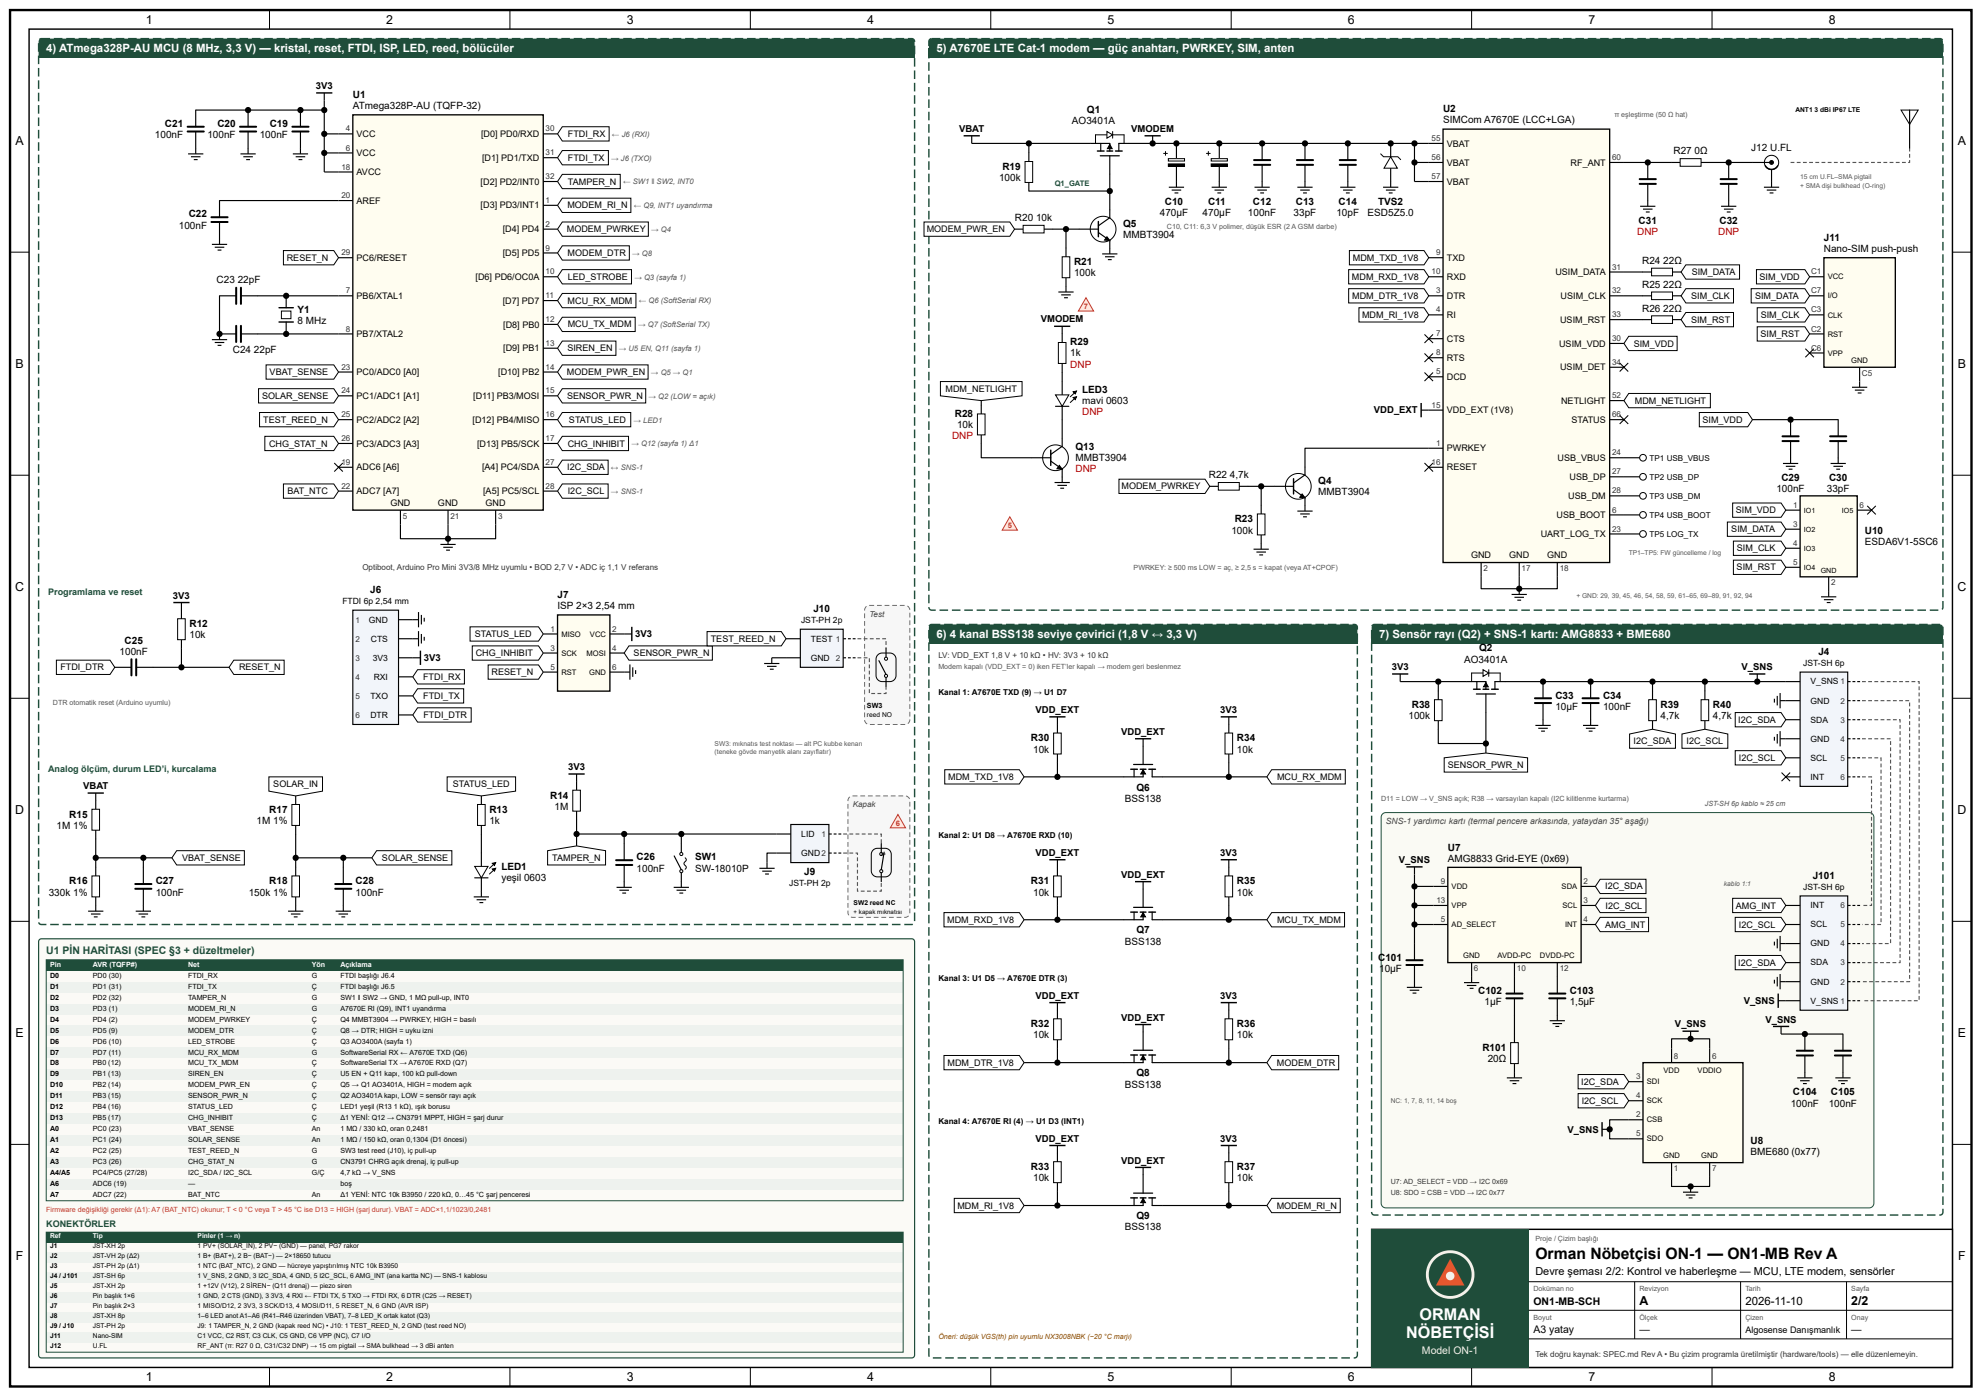
[picture p62: page 2]

4) ATmega328P-AU MCU (8 MHz, 3,3 V) — kristal, reset, FTDI, ISP, LED, reed, bölücüler

5) A7670E LTE Cat-1 modem — güç anahtarı, PWRKEY, SIM, anten

15 cm U.FL–SMA pigtail
+ SMA dişi bulkhead (O-ring)

C10, C11: 6,3 V polimer, düşük ESR (2 A GSM darbe)

Nano-SIM push-push

Optiboot, Arduino Pro Mini 3V3/8 MHz uyumlu • BOD 2,7 V • ADC iç 1,1 V referans

PWRKEY: ≥ 500 ms LOW = aç, ≥ 2,5 s = kapat (veya AT+CPOF)

LV: VDD_EXT 1,8 V + 10 kΩ • HV: 3V3 + 10 kΩ
Modem kapalı (VDD_EXT = 0) iken FET’ler kapalı → modem geri beslenmez

DTR otomatik reset (Arduino uyumlu)

SW3: mıknatıs test noktası — alt PC kubbe kenarı
(teneke gövde manyetik alanı zayıflatır)

Analog ölçüm, durum LED’i, kurcalama

D11 = LOW → V_SNS açık; R38 → varsayılan kapalı (I2C kilitlenme kurtarma)

JST-SH 6p kablo ≈ 25 cm

SNS-1 yardımcı kartı (termal pencere arkasında, yataydan 35° aşağı)

U1 PİN HARİTASI (SPEC §3 + düzeltmeler)

Firmware değişikliği gerekir (Δ1): A7 (BAT_NTC) okunur; T < 0 °C veya T > 45 °C ise D13 = HIGH (şarj durur). VBAT = ADC×1,1/1023/0,2481
KONEKTÖRLER

Proje / Çizim başlığı
Orman Nöbetçisi ON-1 — ON1-MB Rev A
Devre şeması 2/2: Kontrol ve haberleşme — MCU, LTE modem, sensörler

Öneri: düşük VGS(th) pin uyumlu NX3008NBK (−20 °C marjı)

Tek doğru kaynak: SPEC.md Rev A • Bu çizim programla üretilmiştir (hardware/tools) — elle düzenlemeyin.
